Coipel/Water-Tank-Control-Project/README.md

~See documentation here: [Report](Documents/Report.pdf)

Video with GUI application and physical system operating simultaneously below.

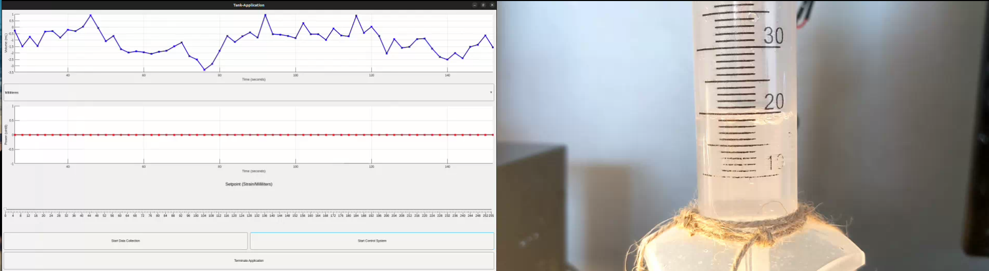
[picture p1: Documents/app_w_tank_sync_thumbnail.png]
Thumbnail (https://drive.google.com/file/d/1SB4pMD3dYZrm-mWkkqUScLVmlw5nNK5k/view?usp=sharing)
